davoxan/Impact_attenuation_test_machine/CIRCUITO VISUAL CONEXIONES_bb.png

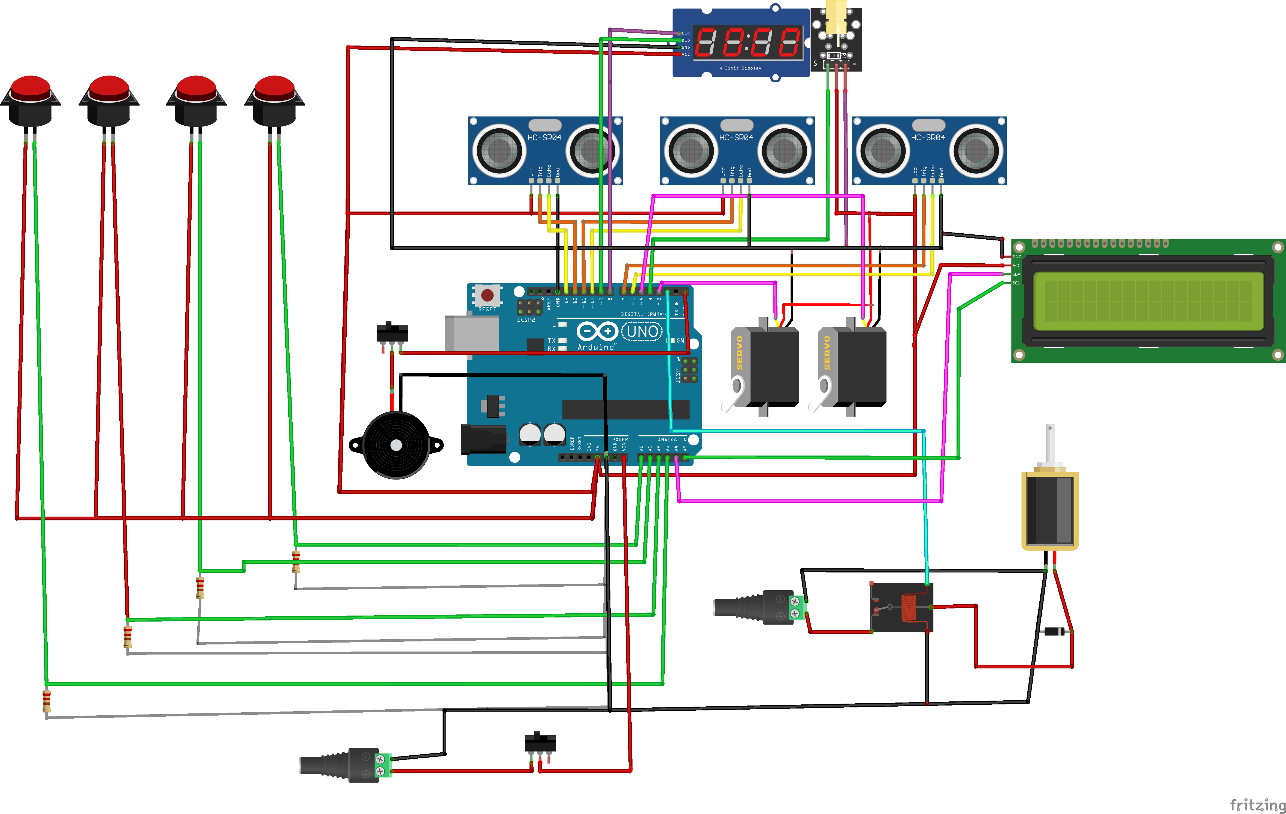
CIRCUITO VISUAL CONEXIONES_bb.png
