davoxan/Impact_attenuation_test_machine/Esquematic circuit.PNG

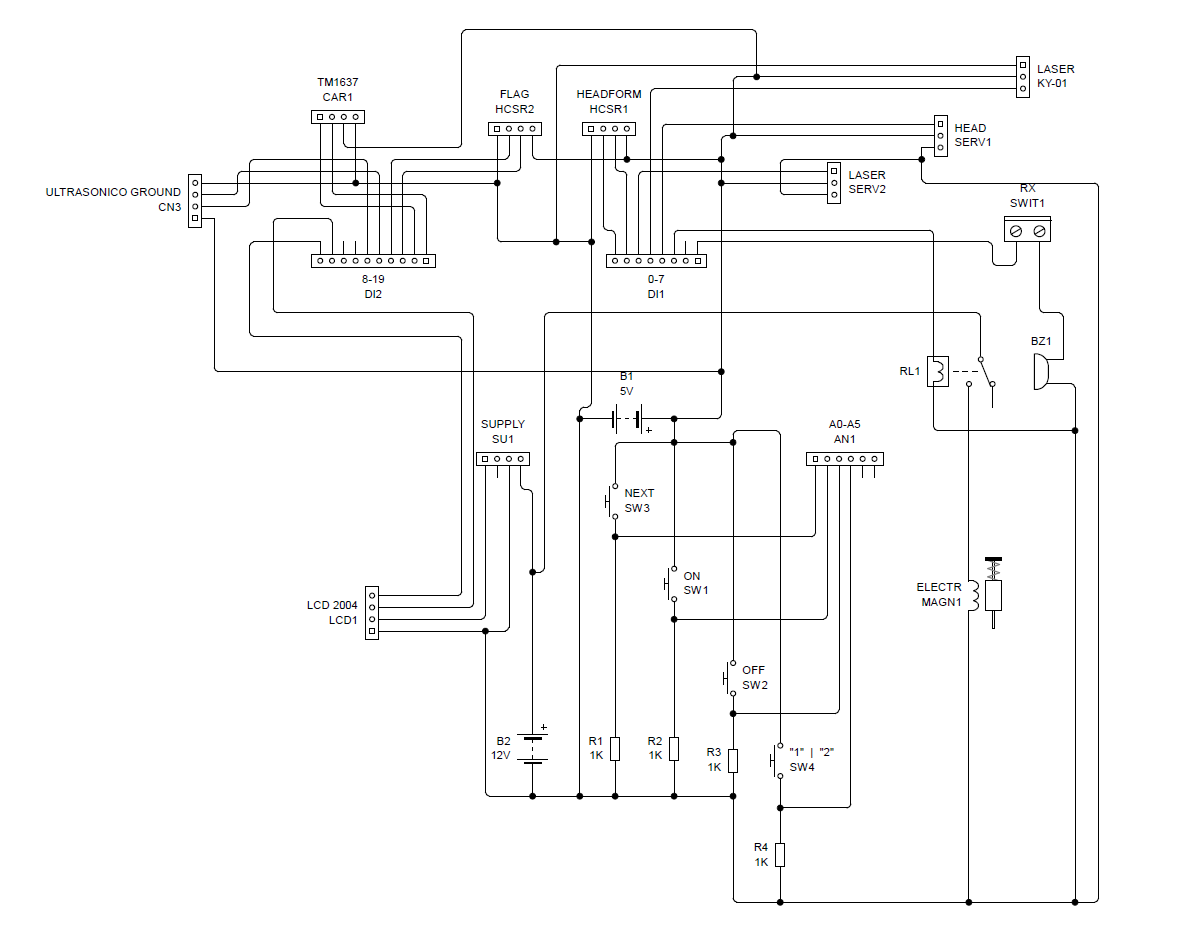
Esquematic circuit.PNG
